Jongmin-Lee-DEV/laser-battle-spider-robot/case/spider_case_all.3mf

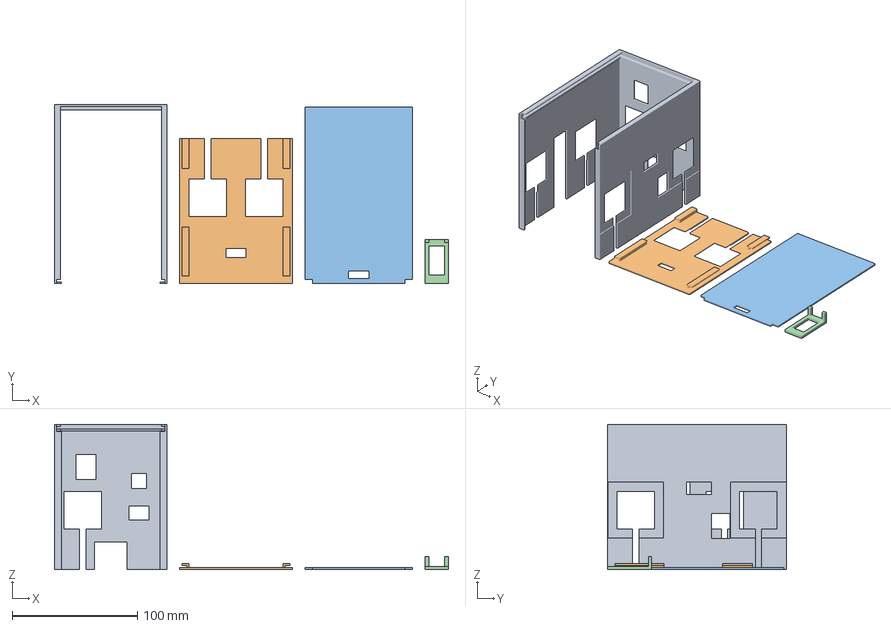
[picture p5: CAD file, 2026-11-03]
case/spider_case_all.3mf
314.8 x 143.1 x 116.0 mm
case_1_body
case_2_back
case_3_lid
case_4_servo_bracket
