Jongmin-Lee-DEV/laser-battle-spider-robot/(list of files, cad)

Other CAD files:
case/spider_case_all.stl
